Jmurrayeng/mPLC/Software/Readme

THe hardware is generic, pick a project folder for a specific application
