Jmurrayeng/mPLC/Hardware/Production FIles/Readme

Production files suitable for upload to JLC pcb
