Jmurrayeng/mPLC/Software/mCNC/Readme

minimally viable cnc drilling machine software

uses two stepper motors (with external drivers) in a Hbot/corexy motor configuration. Z and spindle are on/off only

used as proof of concept, for a real device grblHAL can be used with a modified pinout (create my_machine_map.h) https://github.com/grblHAL/RP2040/discussions/82
