Jmurrayeng/mPLC/Hardware/Schematic.pdf

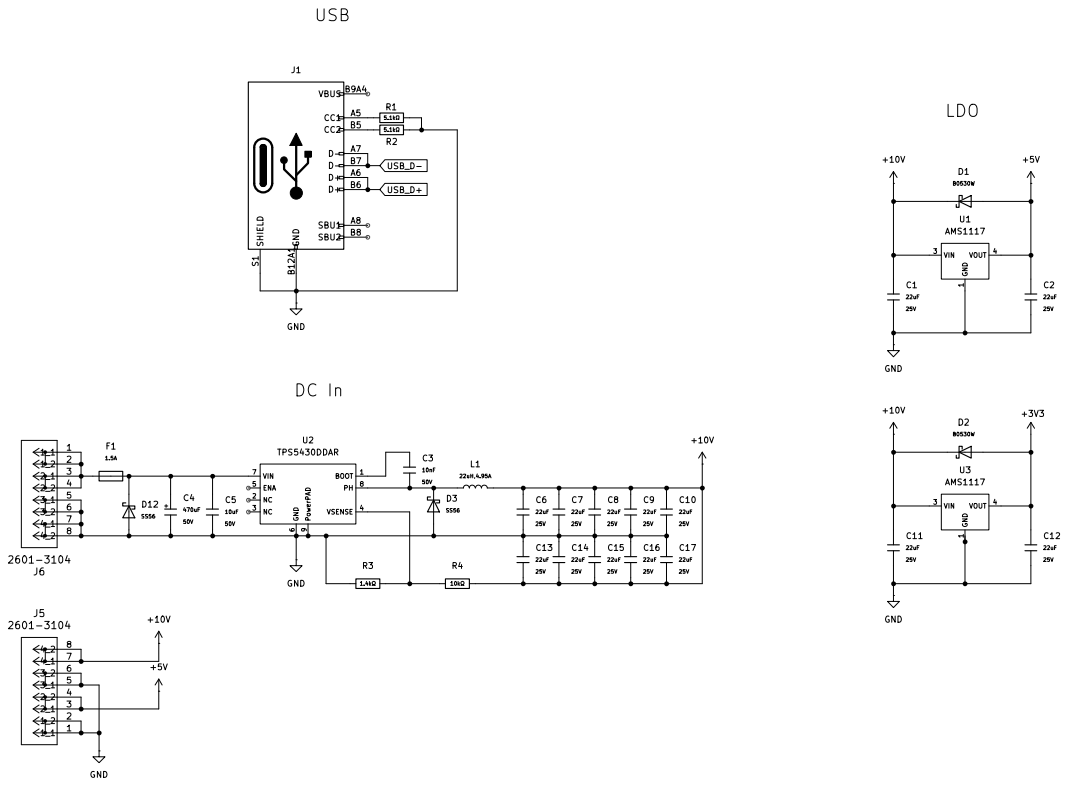
[picture p1: page 2]

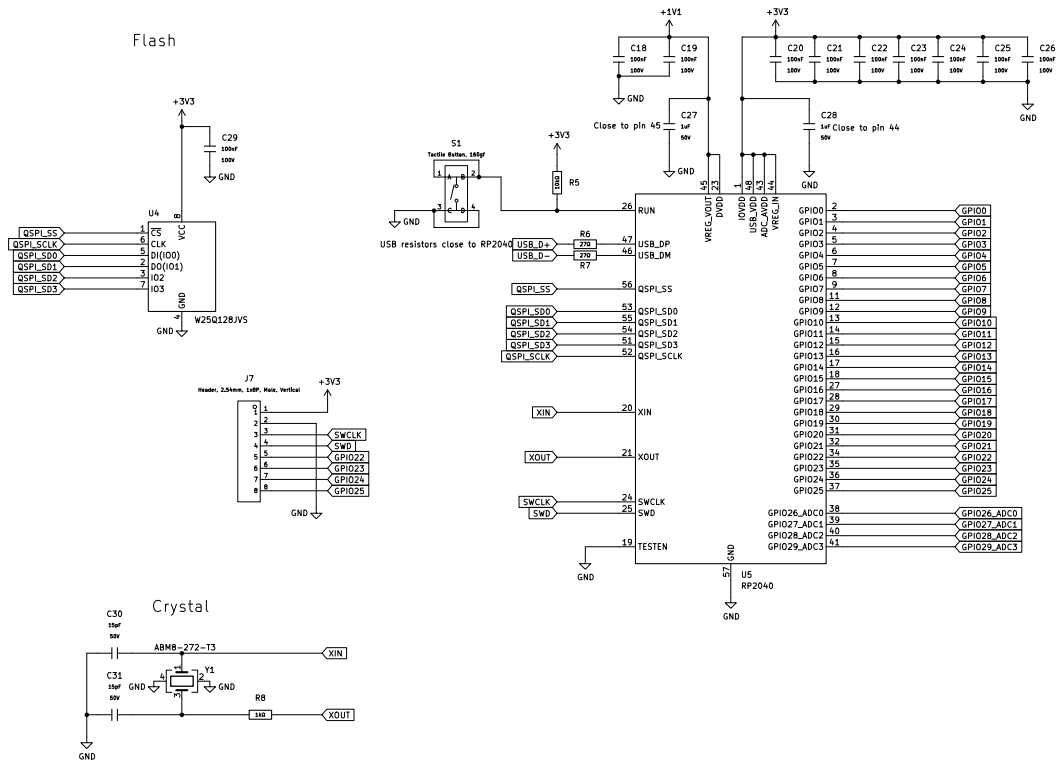
[picture p2: page 3]

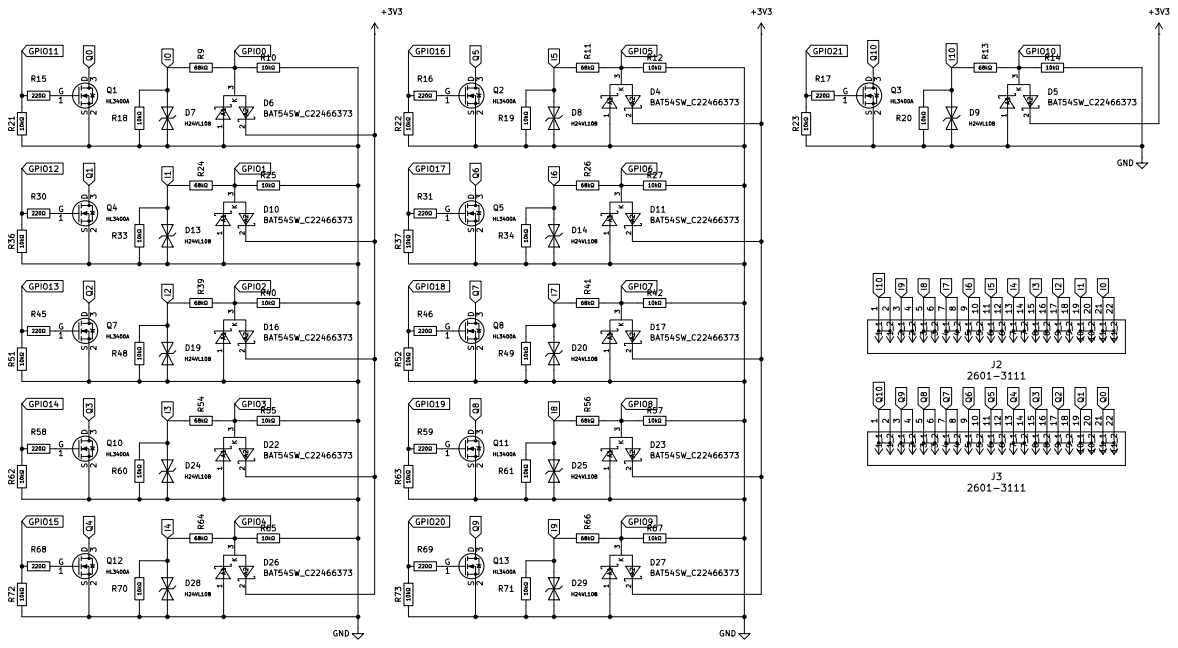
[picture p3: page 4]

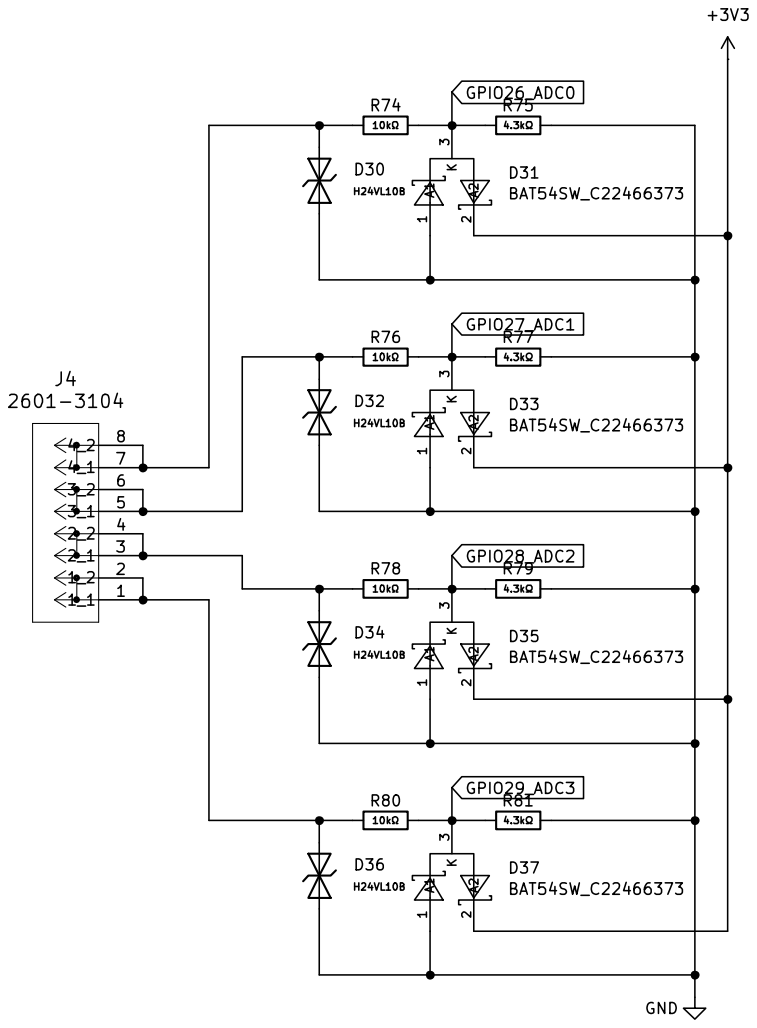
[picture p4: page 5]
