Jmurrayeng/mPLC/Hardware/Kicad FIles/mPLC.kicad_pcb

## KiCad design Hardware/Kicad FIles/mPLC.kicad_pcb (2024-12-26)

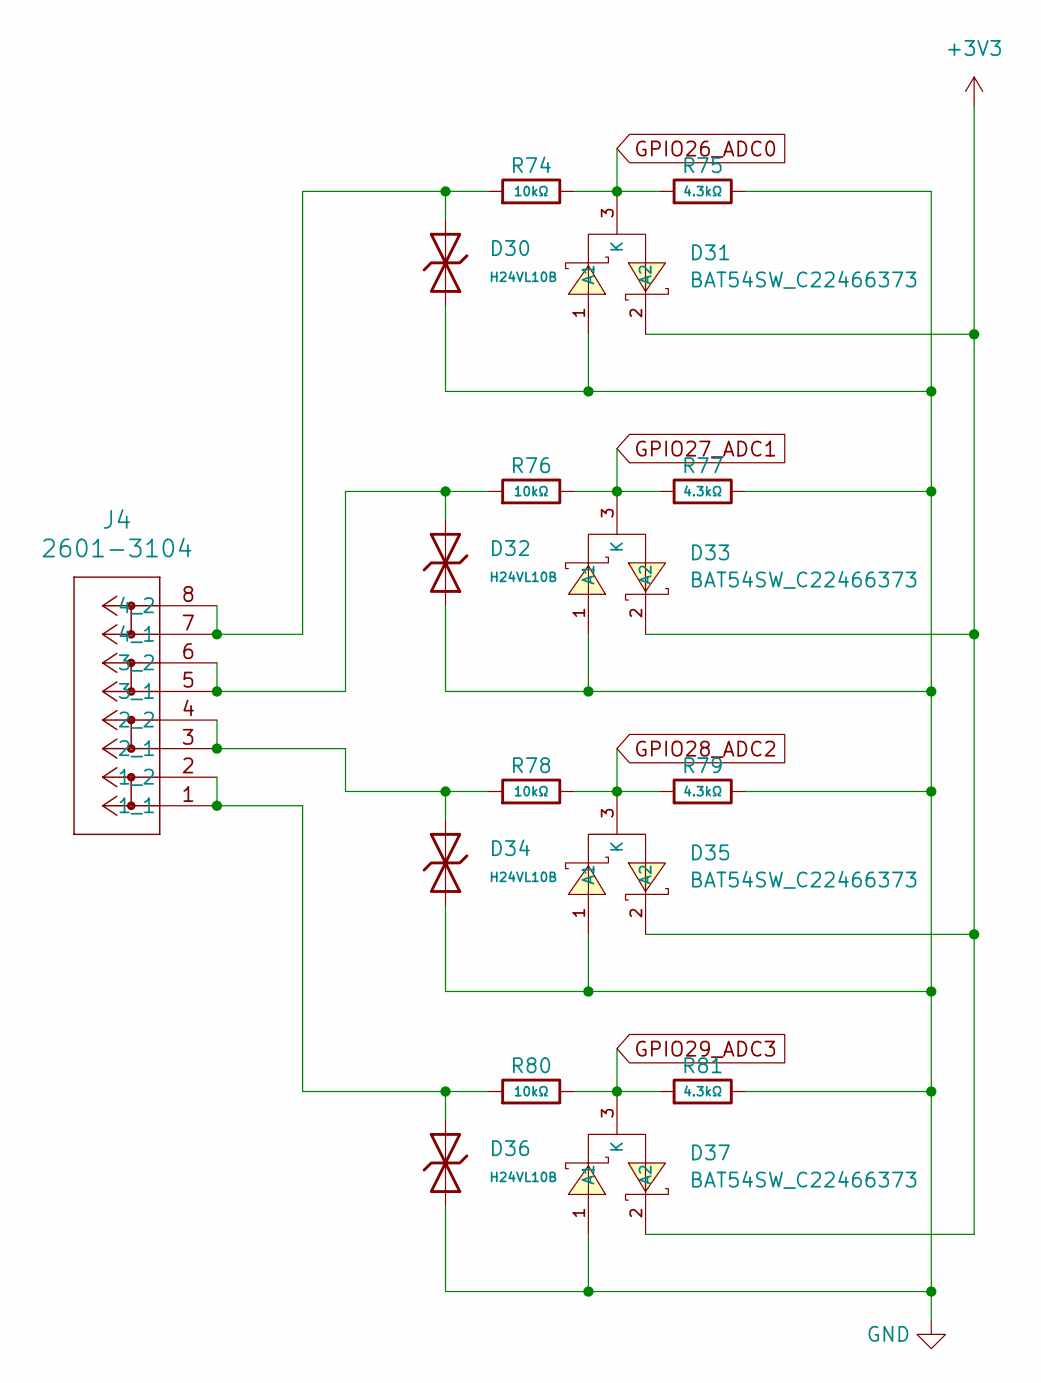
[picture p5: schematic Analog.kicad_sch]

Parts:
D30, D32, D34, D36: H24VL10B; D_DFN1006-2L; Part H24VL10B; LCSC C20617912
D31, D33, D35, D37: BAT54SW_C22466373; SOT-323-3_L2.0-W1.3-P1.30-LS2.1-BR-2; Part BAT54SW; LCSC C22466373
J4: 2601-3104; CONN4_2601-3104_WAG
R74, R76, R78, R80: 10kΩ; R_0805; Overload Voltage (Max) 150V; Tolerance ±1%; Part 0805W8F1002T5E; LCSC C17414
R75, R77, R79, R81: 4.3kΩ; R_0805; Overload Voltage (Max) 150V; Tolerance ±1%; Part 0805W8F4301T5E; LCSC C17667

Connections:
+3V3: D31.2 (A2), D33.2 (A2), D35.2 (A2), D37.2 (A2); also elsewhere on the board
GND: D30.1, D31.1 (A1), D32.1, D33.1 (A1), D34.1, D35.1 (A1), D36.1, D37.1 (A1), R75.2, R77.2, R79.2, R81.2; also elsewhere on the board
GPIO26_ADC0: D31.3 (K), R74.2, R75.1; also elsewhere on the board
GPIO27_ADC1: D33.3 (K), R76.2, R77.1; also elsewhere on the board
GPIO28_ADC2: D35.3 (K), R78.2, R79.1; also elsewhere on the board
GPIO29_ADC3: D37.3 (K), R80.2, R81.1; also elsewhere on the board
unnamed: D36.2, J4.1 (1_1), J4.2 (1_2), R80.1
unnamed: D34.2, J4.3 (2_1), J4.4 (2_2), R78.1
unnamed: D32.2, J4.5 (3_1), J4.6 (3_2), R76.1
unnamed: D30.2, J4.7 (4_1), J4.8 (4_2), R74.1

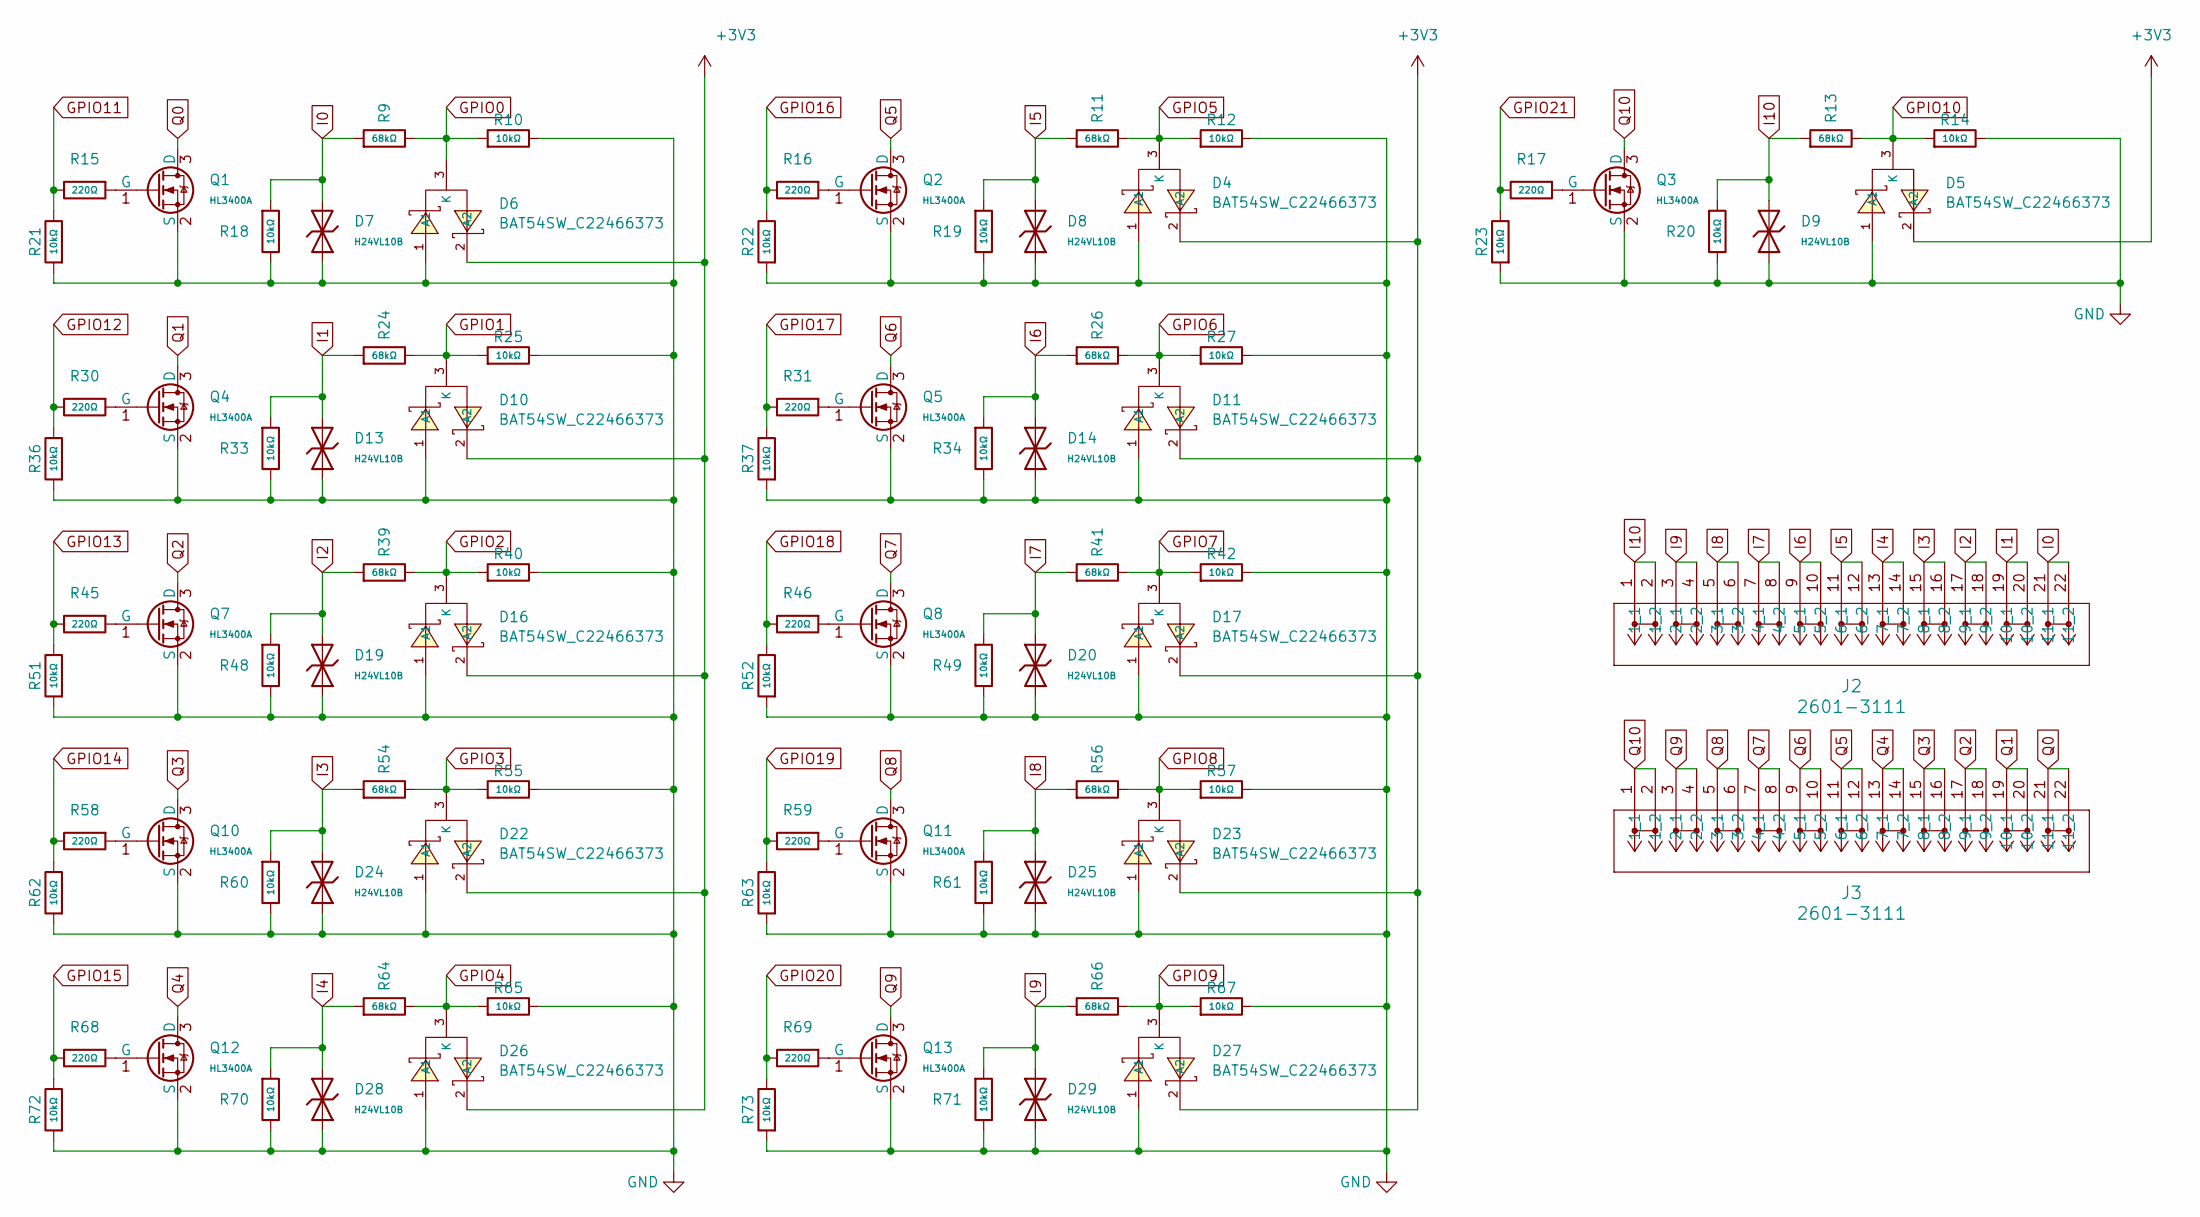
[picture p6: schematic IO.kicad_sch]

Parts:
D4, D5, D6, D10, D11, D16, D17, D22, D23, D26, D27: BAT54SW_C22466373; SOT-323-3_L2.0-W1.3-P1.30-LS2.1-BR-2; Part BAT54SW; LCSC C22466373
D7, D8, D9, D13, D14, D19, D20, D24, D25, D28, D29: H24VL10B; D_DFN1006-2L; Part H24VL10B; LCSC C20617912
J2, J3: 2601-3111; CONN11_2601-3111_WAG
Q1, Q2, Q3, Q4, Q5, Q7, Q8, Q10, Q11, Q12, Q13: HL3400A; Q_SOT-23; Part HL3400A; LCSC C7420348
R9, R11, R13, R24, R26, R39, R41, R54, R56, R64, R66: 68kΩ; R_0805; Overload Voltage (Max) 150V; Tolerance ±1%; Part 0805W8F6802T5E; LCSC C17801
R10, R12, R14, R21, R22, R23, R25, R27, R36, R37, R40, R42, R51, R52, R55, R57, R62, R63, R65, R67, R72, R73: 10kΩ; R_0805; Overload Voltage (Max) 150V; Tolerance ±1%; Part 0805W8F1002T5E; LCSC C17414
R15, R16, R17, R30, R31, R45, R46, R58, R59, R68, R69: 220Ω; R_0805; Overload Voltage (Max) 150V; Tolerance ±1%; Part 0805W8F2200T5E; LCSC C17557
R18, R19, R20, R33, R34, R48, R49, R60, R61, R70, R71: 10kΩ; R_1206; Overload Voltage (Max) 200V; Tolerance ±1%; Part 1206W4F1002T5E; LCSC C17902

Connections:
+3V3: D4.2 (A2), D5.2 (A2), D6.2 (A2), D10.2 (A2), D11.2 (A2), D16.2 (A2), D17.2 (A2), D22.2 (A2), D23.2 (A2), D26.2 (A2), D27.2 (A2); also elsewhere on the board
GND: D4.1 (A1), D5.1 (A1), D6.1 (A1), D7.1, D8.1, D9.1, D10.1 (A1), D11.1 (A1), D13.1, D14.1, D16.1 (A1), D17.1 (A1), D19.1, D20.1, D22.1 (A1), D23.1 (A1), D24.1, D25.1, D26.1 (A1), D27.1 (A1), D28.1, D29.1, Q1.2 (S), Q2.2 (S), Q3.2 (S), Q4.2 (S), Q5.2 (S), Q7.2 (S), Q8.2 (S), Q10.2 (S), Q11.2 (S), Q12.2 (S), Q13.2 (S), R10.2, R12.2, R14.2, R18.2, R19.2, R20.2, R21.1, R22.1, R23.1, R25.2, R27.2, R33.2, R34.2, R36.1, R37.1, R40.2, R42.2, R48.2, R49.2, R51.1, R52.1, R55.2, R57.2, R60.2, R61.2, R62.1, R63.1, R65.2, R67.2, R70.2, R71.2, R72.1, R73.1; also elsewhere on the board
GPIO0: D6.3 (K), R9.2, R10.1; also elsewhere on the board
GPIO1: D10.3 (K), R24.2, R25.1; also elsewhere on the board
GPIO2: D16.3 (K), R39.2, R40.1; also elsewhere on the board
GPIO3: D22.3 (K), R54.2, R55.1; also elsewhere on the board
GPIO4: D26.3 (K), R64.2, R65.1; also elsewhere on the board
GPIO5: D4.3 (K), R11.2, R12.1; also elsewhere on the board
GPIO6: D11.3 (K), R26.2, R27.1; also elsewhere on the board
GPIO7: D17.3 (K), R41.2, R42.1; also elsewhere on the board
GPIO8: D23.3 (K), R56.2, R57.1; also elsewhere on the board
GPIO9: D27.3 (K), R66.2, R67.1; also elsewhere on the board
GPIO10: D5.3 (K), R13.2, R14.1; also elsewhere on the board
GPIO11: R15.2, R21.2; also elsewhere on the board
GPIO12: R30.2, R36.2; also elsewhere on the board
GPIO13: R45.2, R51.2; also elsewhere on the board
GPIO14: R58.2, R62.2; also elsewhere on the board
GPIO15: R68.2, R72.2; also elsewhere on the board
GPIO16: R16.2, R22.2; also elsewhere on the board
GPIO17: R31.2, R37.2; also elsewhere on the board
GPIO18: R46.2, R52.2; also elsewhere on the board
GPIO19: R59.2, R63.2; also elsewhere on the board
GPIO20: R69.2, R73.2; also elsewhere on the board
GPIO21: R17.2, R23.2; also elsewhere on the board
I0: D7.2, J2.21 (11_1), J2.22 (11_2), R9.1, R18.1
I1: D13.2, J2.19 (10_1), J2.20 (10_2), R24.1, R33.1
I2: D19.2, J2.17 (9_1), J2.18 (9_2), R39.1, R48.1
I3: D24.2, J2.15 (8_1), J2.16 (8_2), R54.1, R60.1
I4: D28.2, J2.13 (7_1), J2.14 (7_2), R64.1, R70.1
I5: D8.2, J2.11 (6_1), J2.12 (6_2), R11.1, R19.1
I6: D14.2, J2.9 (5_1), J2.10 (5_2), R26.1, R34.1
I7: D20.2, J2.7 (4_1), J2.8 (4_2), R41.1, R49.1
I8: D25.2, J2.5 (3_1), J2.6 (3_2), R56.1, R61.1
I9: D29.2, J2.3 (2_1), J2.4 (2_2), R66.1, R71.1
I10: D9.2, J2.1 (1_1), J2.2 (1_2), R13.1, R20.1
unnamed: Q1.1 (G), R15.1
unnamed: Q2.1 (G), R16.1
unnamed: Q3.1 (G), R17.1
unnamed: Q4.1 (G), R30.1
unnamed: Q5.1 (G), R31.1
unnamed: Q7.1 (G), R45.1
unnamed: Q8.1 (G), R46.1
unnamed: Q10.1 (G), R58.1
unnamed: Q11.1 (G), R59.1
unnamed: Q12.1 (G), R68.1
unnamed: Q13.1 (G), R69.1
Q0: J3.21 (11_1), J3.22 (11_2), Q1.3 (D)
Q1: J3.19 (10_1), J3.20 (10_2), Q4.3 (D)
Q2: J3.17 (9_1), J3.18 (9_2), Q7.3 (D)
Q3: J3.15 (8_1), J3.16 (8_2), Q10.3 (D)
Q4: J3.13 (7_1), J3.14 (7_2), Q12.3 (D)
Q5: J3.11 (6_1), J3.12 (6_2), Q2.3 (D)
Q6: J3.9 (5_1), J3.10 (5_2), Q5.3 (D)
Q7: J3.7 (4_1), J3.8 (4_2), Q8.3 (D)
Q8: J3.5 (3_1), J3.6 (3_2), Q11.3 (D)
Q9: J3.3 (2_1), J3.4 (2_2), Q13.3 (D)
Q10: J3.1 (1_1), J3.2 (1_2), Q3.3 (D)

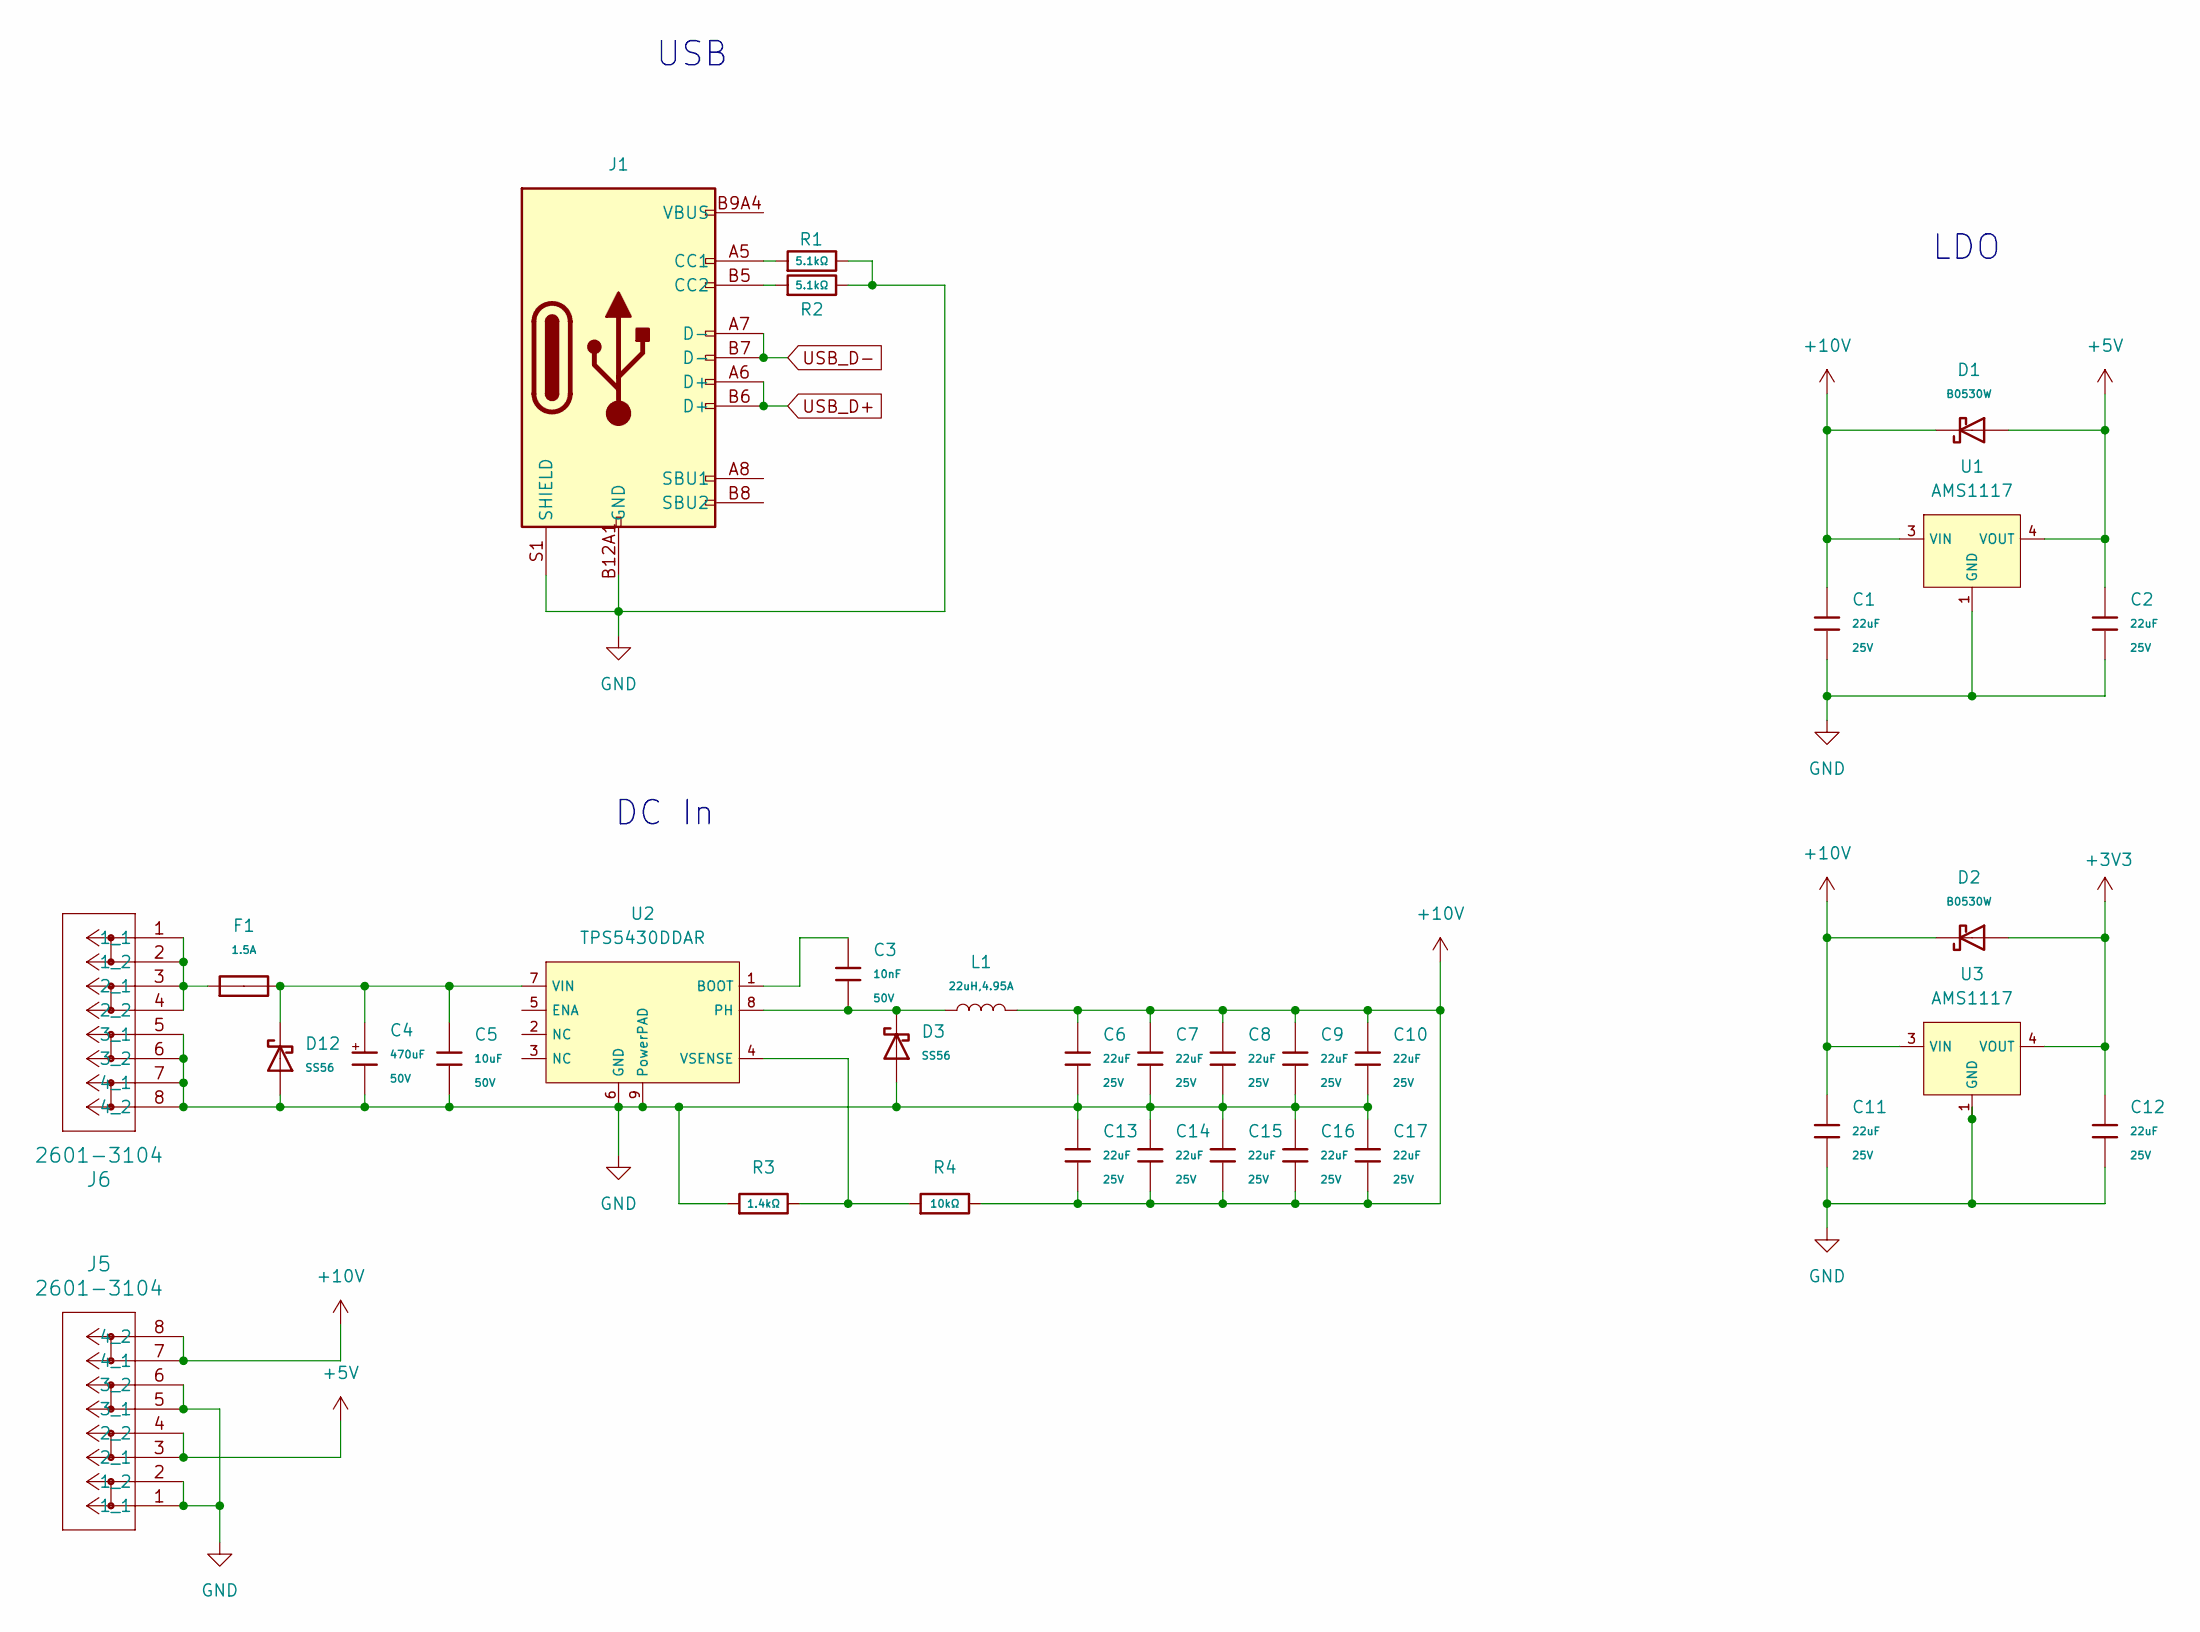
[picture p7: schematic PUSB.kicad_sch]

Parts:
C1, C2, C11, C12: 22uF; C_0805; Voltage Rated 25V; Tolerance ±20%; Part CL21A226MAQNNNE; LCSC C45783
C3: 10nF; C_0805; Voltage Rated 50V; Tolerance ±10%; Part CL21B103KBANNNC; LCSC C1710
C4: 470uF; C_Plugin,D10xL16mm; Voltage Rated 50V; Part EGT477M1HG16RRS0P; LCSC C3015599
C5: 10uF; C_0805; Voltage Rated 50V; Tolerance ±10%; Part GRM21BR61H106KE43L; LCSC C440198
C6, C7, C8, C9, C10, C13, C14, C15, C16, C17: 22uF; C_1206; Voltage Rated 25V; Tolerance ±10%; Part CL31A226KAHNNNE; LCSC C12891
D1, D2: B0530W; D_SOD-123; Part B0530W; LCSC C7502708
D3, D12: SS56; D_SMC; Part SS56; LCSC C2898934
F1: 1.5A; F_1206; Part SRF1206P150; LCSC C2838983
J1: Connector, USB-TYPE-C-16P; TYPE-C-SMD_HX-TYPE-C-16PIN; LCSC C2927039
J5, J6: 2601-3104; CONN4_2601-3104_WAG
L1: 22uH,4.95A; L_SMD,12.5x12.5mm; Part SMDRI129-220MT; LCSC C2924827
R1, R2: 5.1kΩ; R_0805; Overload Voltage (Max) 150V; Tolerance ±1%; Part 0805W8F5101T5E; LCSC C27834
R3: 1.4kΩ; R_0805; Part CR0805F81401G; LCSC C101470
R4: 10kΩ; R_0805; Overload Voltage (Max) 150V; Tolerance ±1%; Part 0805W8F1002T5E; LCSC C17414
U1: AMS1117; SOT-223_L6.5-W3.5-P2.30-LS7.0-BR; Output Voltage 5V~5V; Dropout Voltage 1.3V@(1A); Part AMS1117-5.0; LCSC C6187
U2: TPS5430DDAR; ESOP-8_L4.9-W3.9-P1.27-LS6.0-TL-EP; Output Voltage 1.221V~32.04V; Input Voltage 5.5V~36V; Part TPS5430DDAR; LCSC C9864
U3: AMS1117; SOT-223-3_L6.5-W3.4-P2.30-LS7.0-BR; Output Voltage 3.3V~3.3V; Dropout Voltage 1.3V@(800mA); Part AMS1117-3.3; LCSC C6186

Connections:
+3V3: C12.1, D2.2, U3.2 (VOUT), U3.4 (VOUT); also elsewhere on the board
+5V: C2.1, D1.2, J5.3 (2_1), J5.4 (2_2), U1.2 (VOUT), U1.4 (VOUT)
+10V: C1.1, C6.1, C7.1, C8.1, C9.1, C10.1, C11.1, C13.2, C14.2, C15.2, C16.2, C17.2, D1.1, D2.1, J5.7 (4_1), J5.8 (4_2), L1.2, R4.2, U1.3 (VIN), U3.3 (VIN)
GND: C1.2, C2.2, C4.2, C5.2, C6.2, C7.2, C8.2, C9.2, C10.2, C11.2, C12.2, C13.1, C14.1, C15.1, C16.1, C17.1, D3.2, D12.2, J1.A12B1 (GND), J1.B12A1 (GND), J1.S1 (SHIELD), J5.1 (1_1), J5.2 (1_2), J5.5 (3_1), J5.6 (3_2), J6.5 (3_1), J6.6 (3_2), J6.7 (4_1), J6.8 (4_2), R1.2, R2.2, R3.1, U1.1 (GND), U2.6 (GND), U2.9 (PowerPAD), U3.1 (GND); also elsewhere on the board
unnamed: J1.A5 (CC1), R1.1
unnamed: J1.B5 (CC2), R2.1
unnamed: J1.A9B4 (VBUS), J1.B9A4 (VBUS)
unnamed: F1.1, J6.1 (1_1), J6.2 (1_2), J6.3 (2_1), J6.4 (2_2)
unnamed: C3.1, U2.1 (BOOT)
unnamed: C3.2, D3.1, L1.1, U2.8 (PH)
unnamed: C4.1, C5.1, D12.1, F1.2, U2.7 (VIN)
unnamed: R3.2, R4.1, U2.4 (VSENSE)
USB_D+: J1.A6 (D+), J1.B6 (D+); also elsewhere on the board
USB_D-: J1.A7 (D-), J1.B7 (D-); also elsewhere on the board

Notes on the sheet:
LDO
USB
DC In

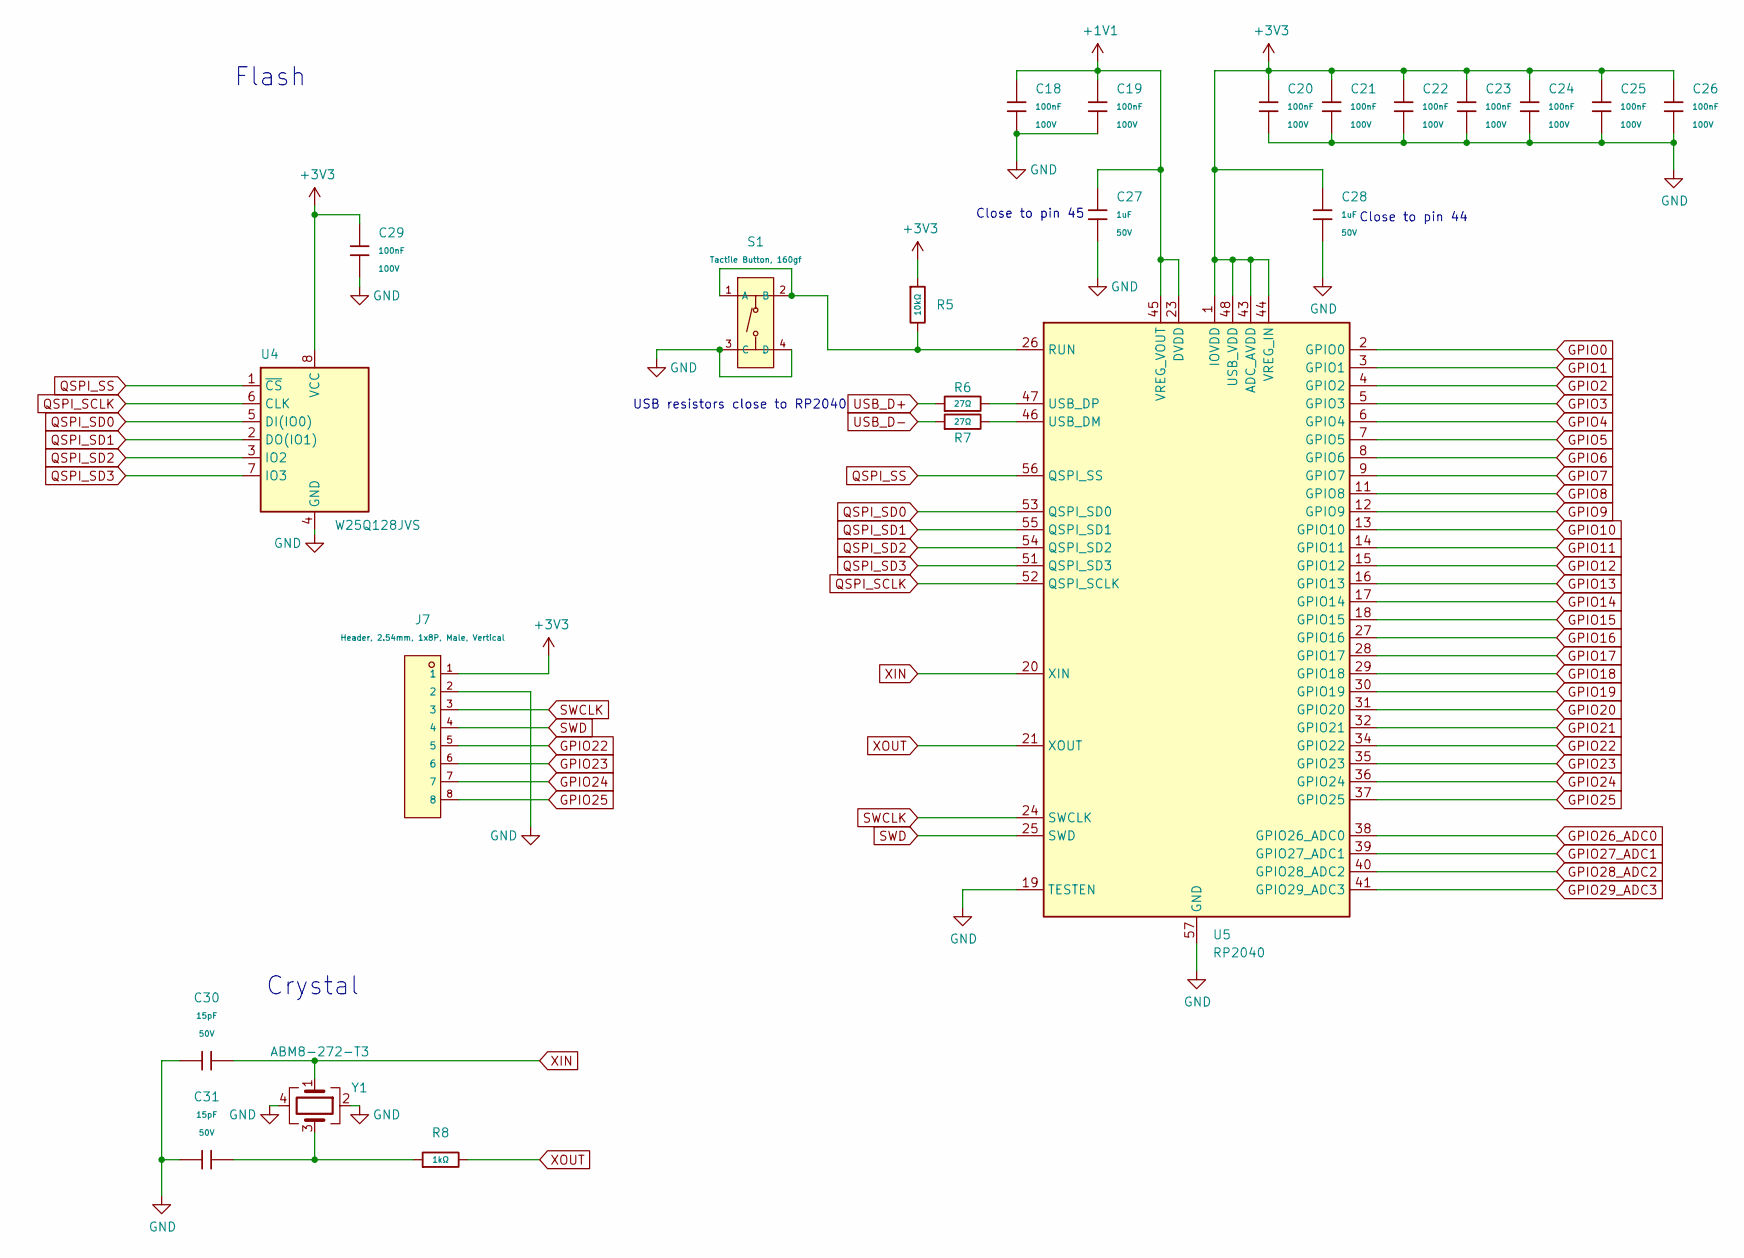
[picture p8: schematic MCU.kicad_sch]

Parts:
C18, C19, C20, C21, C22, C23, C24, C25, C26, C29: 100nF; C_0805; Voltage Rated 100V; Tolerance ±10%; Part CL21B104KCFNNNE; LCSC C28233
C27, C28: 1uF; C_0805; Voltage Rated 50V; Tolerance ±10%; Part CL21B105KBFNNNE; LCSC C28323
C30, C31: 15pF; C_0805; Voltage Rated 50V; Tolerance ±5%; Part CC0805JRNPO9BN150; LCSC C107110
J7: Header, 2.54mm, 1x8P, Male, Vertical; HDR-TH_8P-P2.54-V-M; Part PH-00250; LCSC C2829996
R5: 10kΩ; R_0805; Overload Voltage (Max) 150V; Tolerance ±1%; Part 0805W8F1002T5E; LCSC C17414
R6, R7: 27Ω; R_0805; Overload Voltage (Max) 150V; Tolerance ±1%; Part 0805W8F270JT5E; LCSC C17594
R8: 1kΩ; R_0805; Overload Voltage (Max) 150V; Tolerance ±1%; Part 0805W8F1001T5E; LCSC C17513
S1: Tactile Button, 160gf; SW-SMD_4P-L5.1-W5.1-P3.70-LS6.5-TL-2; Voltage Rating (Dc) 12V; Part TS-1187A-B-A-B; LCSC C318884
U4: W25Q128JVS; SOIC-8_5.23x5.23mm_P1.27mm
U5: RP2040; QFN-56-1EP_7x7mm_P0.4mm_EP3.2x3.2mm
Y1: ABM8-272-T3; Crystal_SMD_3225-4Pin_3.2x2.5mm

Connections:
+1V1: C18.1, C19.1, C27.1, U5.23 (DVDD), U5.45 (VREG_VOUT), U5.50 (DVDD)
+3V3: C20.1, C21.1, C22.1, C23.1, C24.1, C25.1, C26.1, C28.1, C29.1, J7.1, R5.1, U4.8 (VCC), U5.1 (IOVDD), U5.10 (IOVDD), U5.22 (IOVDD), U5.33 (IOVDD), U5.42 (IOVDD), U5.43 (ADC_AVDD), U5.44 (VREG_IN), U5.48 (USB_VDD), U5.49 (IOVDD); also elsewhere on the board
GND: C18.2, C19.2, C20.2, C21.2, C22.2, C23.2, C24.2, C25.2, C26.2, C27.2, C28.2, C29.2, C30.1, C31.1, J7.2, S1.3 (C), S1.4 (D), U4.4 (GND), U5.19 (TESTEN), U5.57 (GND), Y1.2, Y1.4; also elsewhere on the board
GPIO0: U5.2 (GPIO0); also elsewhere on the board
GPIO1: U5.3 (GPIO1); also elsewhere on the board
GPIO2: U5.4 (GPIO2); also elsewhere on the board
GPIO3: U5.5 (GPIO3); also elsewhere on the board
GPIO4: U5.6 (GPIO4); also elsewhere on the board
GPIO5: U5.7 (GPIO5); also elsewhere on the board
GPIO6: U5.8 (GPIO6); also elsewhere on the board
GPIO7: U5.9 (GPIO7); also elsewhere on the board
GPIO8: U5.11 (GPIO8); also elsewhere on the board
GPIO9: U5.12 (GPIO9); also elsewhere on the board
GPIO10: U5.13 (GPIO10); also elsewhere on the board
GPIO11: U5.14 (GPIO11); also elsewhere on the board
GPIO12: U5.15 (GPIO12); also elsewhere on the board
GPIO13: U5.16 (GPIO13); also elsewhere on the board
GPIO14: U5.17 (GPIO14); also elsewhere on the board
GPIO15: U5.18 (GPIO15); also elsewhere on the board
GPIO16: U5.27 (GPIO16); also elsewhere on the board
GPIO17: U5.28 (GPIO17); also elsewhere on the board
GPIO18: U5.29 (GPIO18); also elsewhere on the board
GPIO19: U5.30 (GPIO19); also elsewhere on the board
GPIO20: U5.31 (GPIO20); also elsewhere on the board
GPIO21: U5.32 (GPIO21); also elsewhere on the board
GPIO22: J7.5, U5.34 (GPIO22)
GPIO23: J7.6, U5.35 (GPIO23)
GPIO24: J7.7, U5.36 (GPIO24)
GPIO25: J7.8, U5.37 (GPIO25)
GPIO26_ADC0: U5.38 (GPIO26_ADC0); also elsewhere on the board
GPIO27_ADC1: U5.39 (GPIO27_ADC1); also elsewhere on the board
GPIO28_ADC2: U5.40 (GPIO28_ADC2); also elsewhere on the board
GPIO29_ADC3: U5.41 (GPIO29_ADC3); also elsewhere on the board
unnamed: C31.2, R8.1, Y1.3
unnamed: R5.2, S1.1 (A), S1.2 (B), U5.26 (RUN)
unnamed: R7.2, U5.46 (USB_DM)
unnamed: R6.2, U5.47 (USB_DP)
QSPI_SCLK: U4.6 (CLK), U5.52 (QSPI_SCLK)
QSPI_SD0: U4.5 (DI(IO0)), U5.53 (QSPI_SD0)
QSPI_SD1: U4.2 (DO(IO1)), U5.55 (QSPI_SD1)
QSPI_SD2: U4.3 (IO2), U5.54 (QSPI_SD2)
QSPI_SD3: U4.7 (IO3), U5.51 (QSPI_SD3)
QSPI_SS: U4.1 (~CS), U5.56 (QSPI_SS)
SWCLK: J7.3, U5.24 (SWCLK)
SWD: J7.4, U5.25 (SWD)
USB_D+: R6.1; also elsewhere on the board
USB_D-: R7.1; also elsewhere on the board
XIN: C30.2, U5.20 (XIN), Y1.1
XOUT: R8.2, U5.21 (XOUT)

Notes on the sheet:
USB resistors close to RP2040
Close to pin 44
Crystal
Flash
Close to pin 45

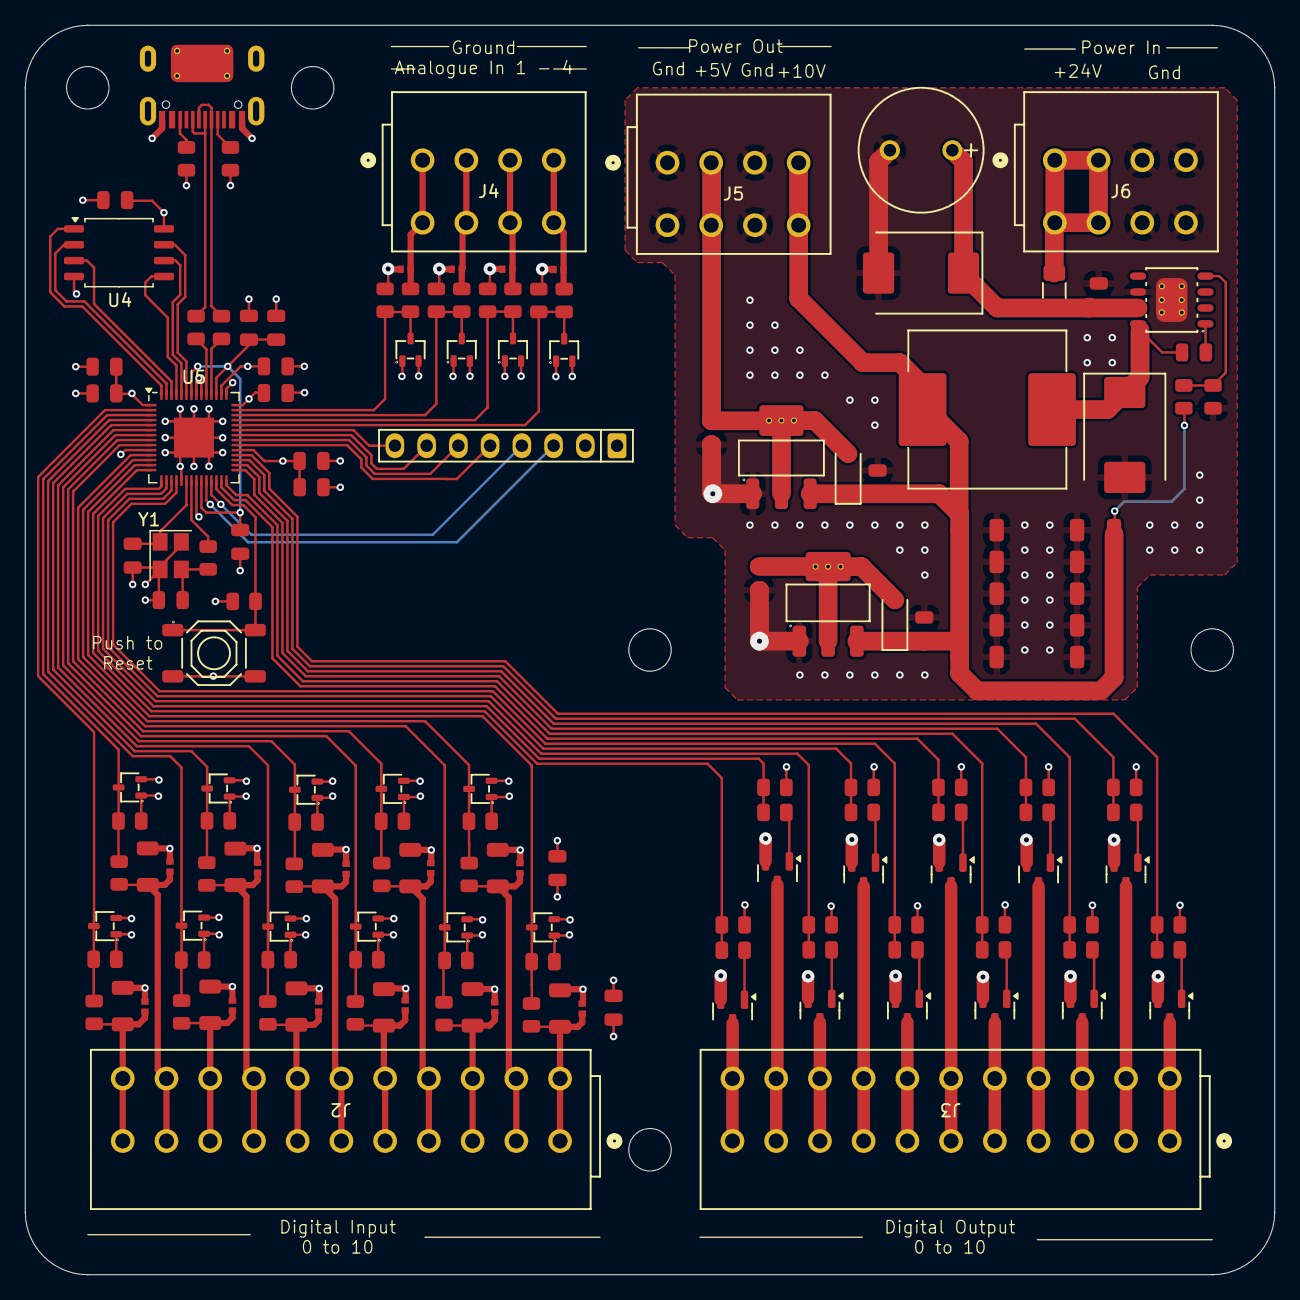
[picture p9: board mPLC.kicad_pcb from above]

Board: 4 copper layers, 100.0 x 100.0 mm, 163 parts (0 on the bottom side), 96 nets.
